felixkoe/MotoSense/Bilder/Bilder Demo Video/Drehzahl test.jpeg

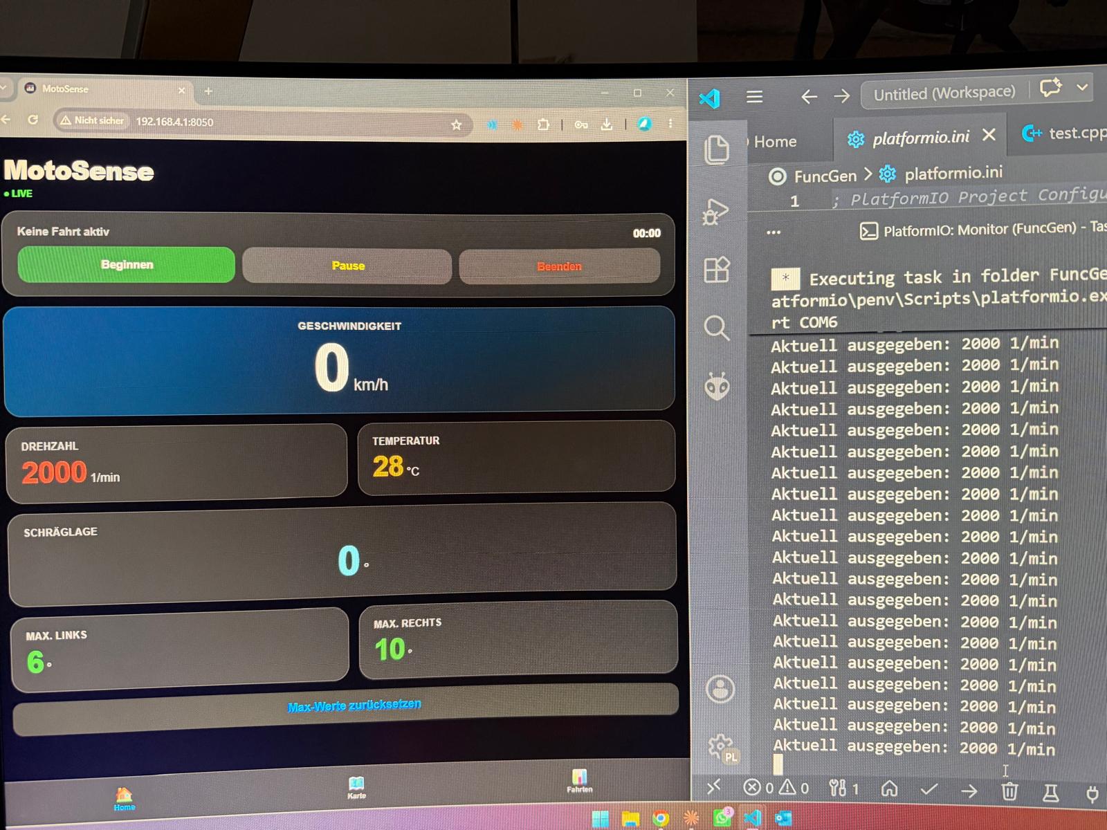
Bilder/Bilder Demo Video/Drehzahl test.jpeg
