felixkoe/MotoSense/Bilder/Bilder Demo Video/Systemaufbau.jpeg

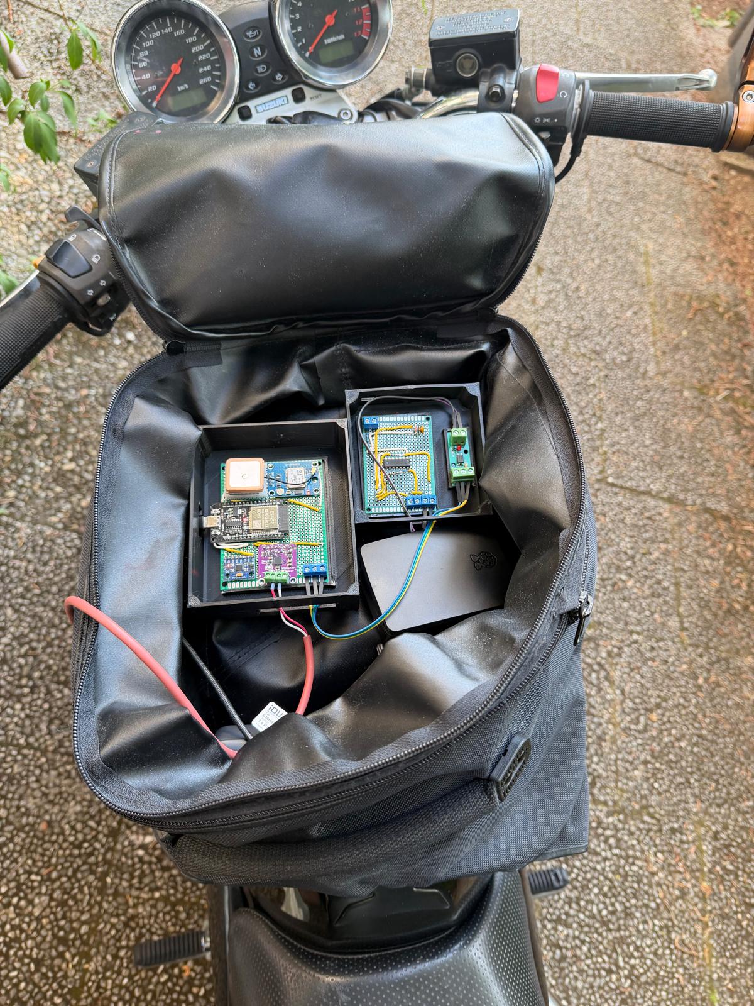
Bilder/Bilder Demo Video/Systemaufbau.jpeg
