felixkoe/MotoSense/Docs/OTH_DAPI_Commit_Historie.pdf

Commit-Historie

Datum | Commit-Nachricht
16.04.2026 | Initial commit
16.04.2026 | created basic folder structure, changed README
16.04.2026 | changed README
16.04.2026 | Erste CAD-Modelle esp32 Sensor gehäuse
18.04.2026 | Schaltplan Drehzahlmesserschaltung (Schmitt-Trigger, Optokoppler)
19.04.2026 | RPM-Gehäuse
26.04.2026 | Stromverteiler-Gehäuse modelliert
02.05.2026 | GPS-Modul (NEO-6M) an UART2 anschließen und testen
05.05.2026 | MPU-6050 an I2C anschließen
10.05.2026 | RPM-Interrupt an GPIO27, Plausibilitätsfilter implementieren
13.05.2026 | lastPulseUs in setup() initialisieren, ISR-Bug beheben
17.05.2026 | Alle Sensoren zusammenführen, JSON-Payload auf motosense/data
22.05.2026 | RPM Debugging
27.05.2026 | fake_esp.py auf 9-Phasen-Fahrsimulation umstellen
01.06.2026 | Mosquitto-Konfiguration, WiFi und MQTT-Publishing am ESP32
03.06.2026 | Erstes Dash-Dashboard mit Gauges, Karte, Temperaturverlauf
06.06.2026 | db.py mit SQLite, RideRecorder und Haversine-Distanz
11.06.2026 | Dash-Callbacks nach Tab aufteilen, MQTT-Subscribe in on_connect, Dashboard finished
14.06.2026 | Raspberry Pi als Access-Point konfigurieren, systemd-Service einrichten
19.06.2026 | Kalibrierungsoffset, Stillstandsschwellwerte und RPM-Parameter anpassen
22.06.2026 | Dokumentation und Video
