felixkoe/MotoSense/Bilder/sensor_board.jpeg

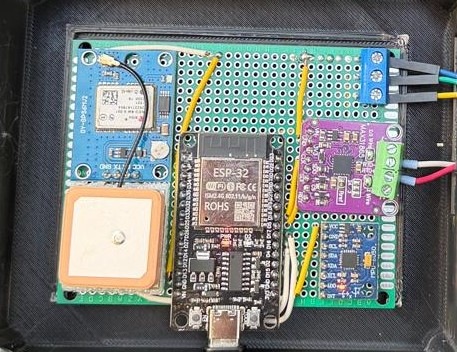
Bilder/sensor_board.jpeg
