felixkoe/MotoSense/Bilder/WhatsApp Image 2026-06-18 at 11.00.58 (1).jpeg

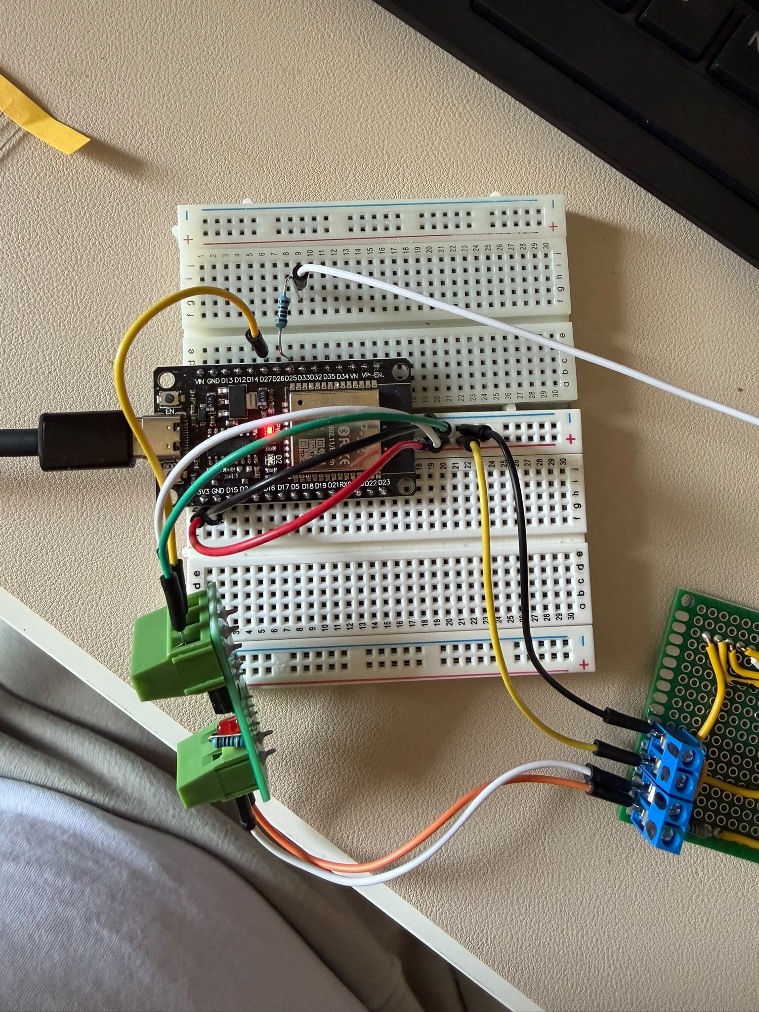
Bilder/WhatsApp Image 2026-06-18 at 11.00.58 (1).jpeg
