felixkoe/MotoSense/Bilder/WhatsApp Image 2026-06-22 at 18.42.49 (1).jpeg

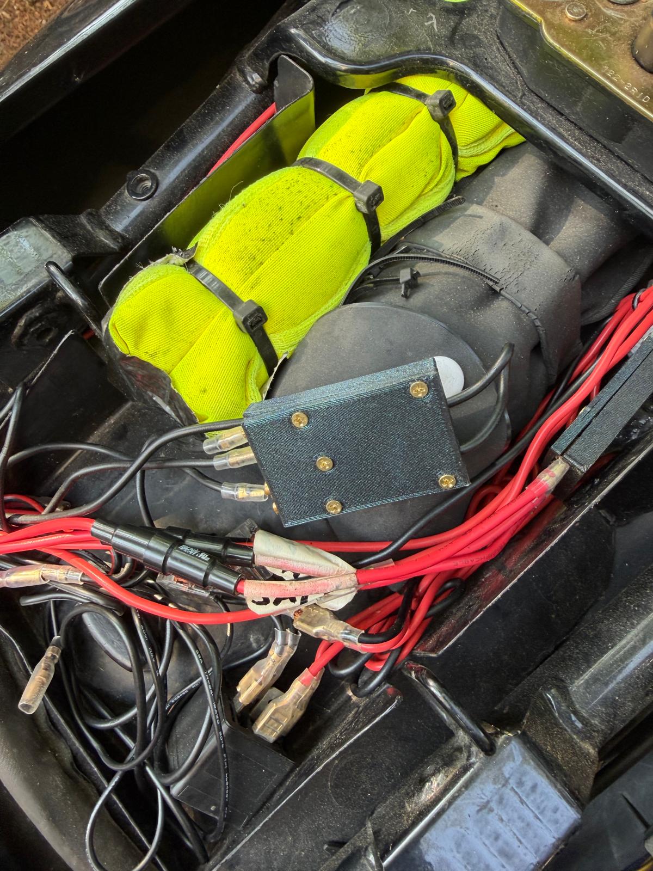
Bilder/WhatsApp Image 2026-06-22 at 18.42.49 (1).jpeg
