felixkoe/MotoSense/Bilder/WhatsApp Image 2026-06-22 at 18.42.49 (5).jpeg

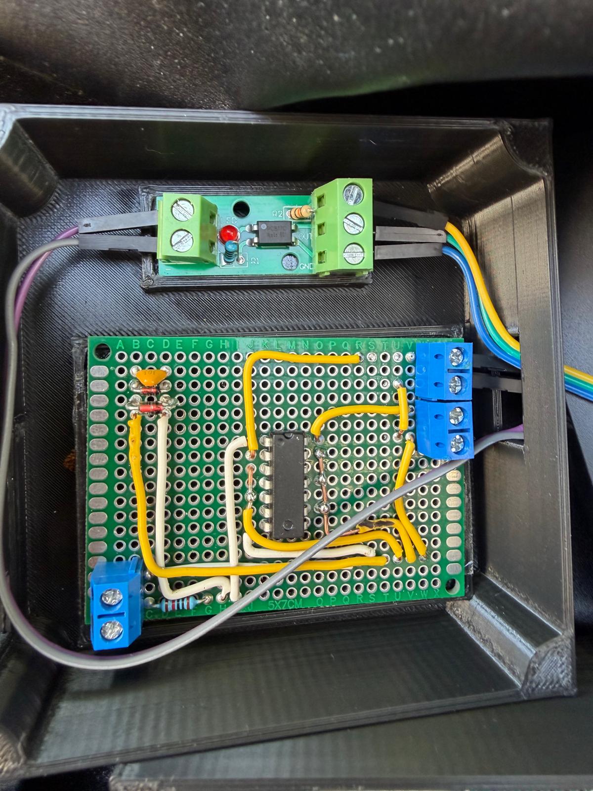
Bilder/WhatsApp Image 2026-06-22 at 18.42.49 (5).jpeg
