felixkoe/MotoSense/Docs/Schaltpläne/Schaltplan RPM Sensor.png

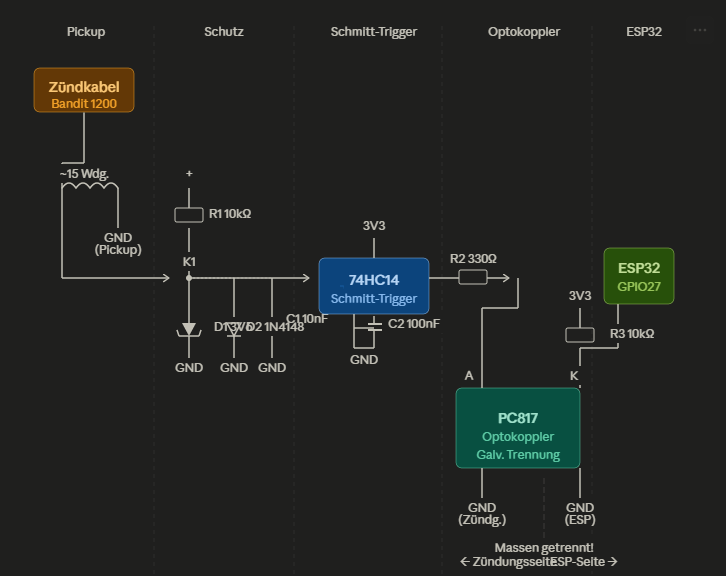
Docs/Schaltpläne/Schaltplan RPM Sensor.png
