felixkoe/MotoSense/CAD/Kabelverteiler_1.stl

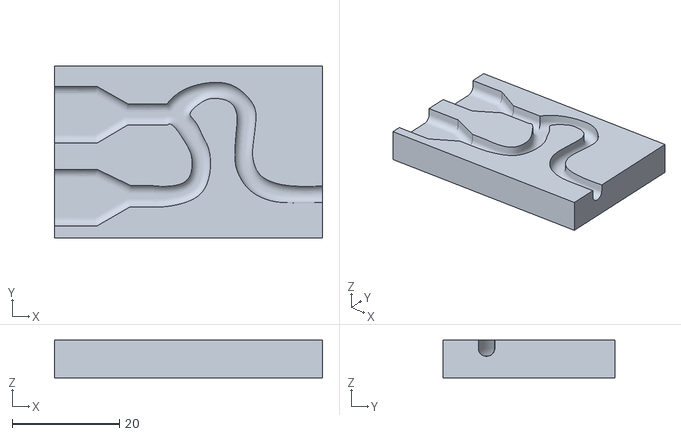
[picture p22: CAD file, 2026-04-25]
CAD/Kabelverteiler_1.stl
50.0 x 32.0 x 7.00
