felixkoe/MotoSense/CAD/Kabelverteiler_2.stl

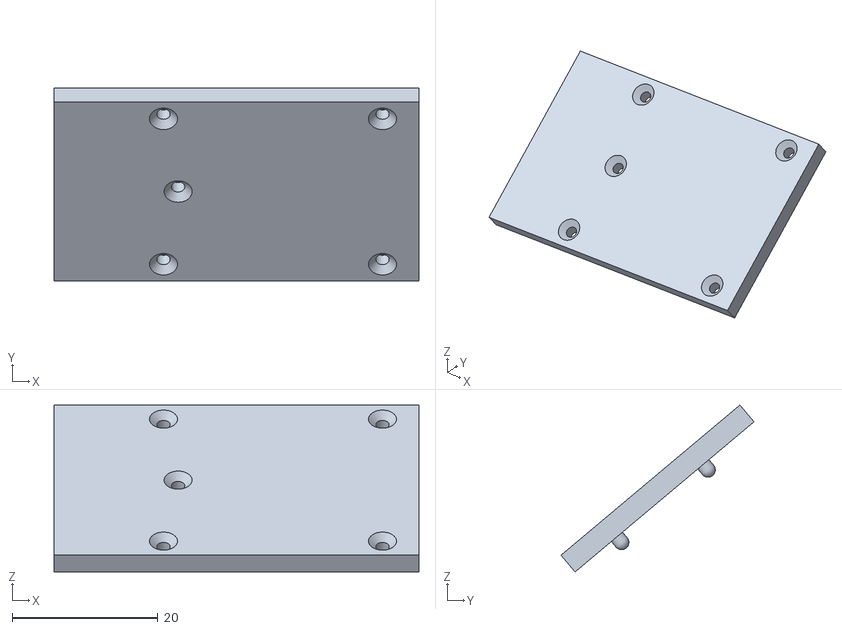
[picture p23: CAD file, 2026-04-25]
CAD/Kabelverteiler_2.stl
50.0 x 26.4 x 22.9
