felixkoe/MotoSense/CAD/RPM_CASE_2.stl

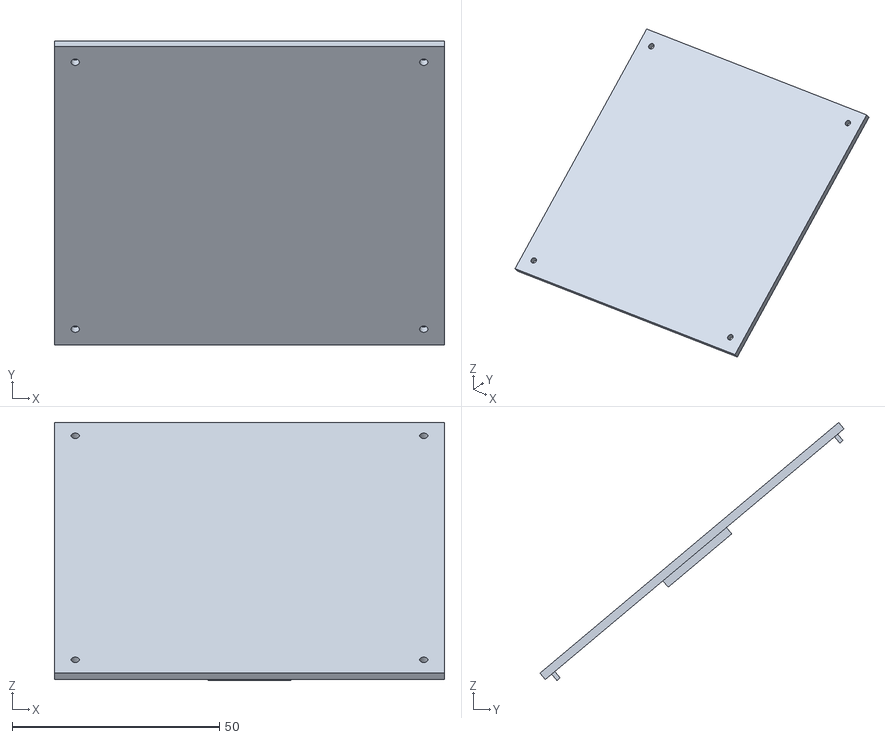
[picture p24: CAD file, 2026-04-19]
CAD/RPM_CASE_2.stl
94.0 x 73.3 x 62.2
