felixkoe/MotoSense/CAD/RPM_CASE_1.stl

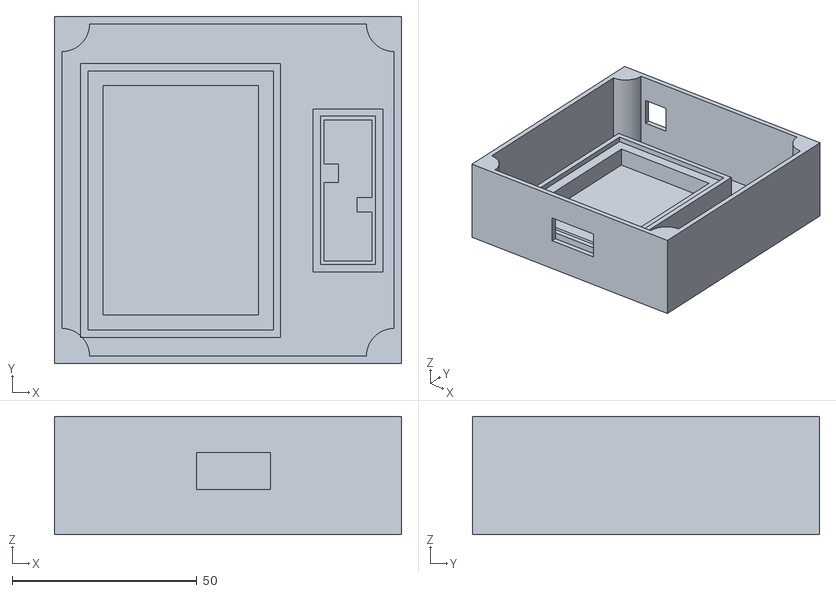
[picture p25: CAD file, 2026-04-19]
CAD/RPM_CASE_1.stl
94.0 x 94.0 x 32.0
