felixkoe/MotoSense/CAD/Sensor_CASE_1.stl

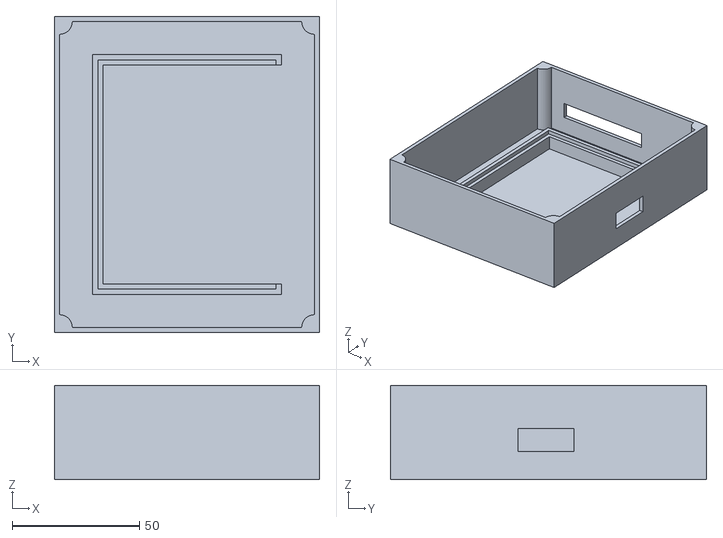
[picture p26: CAD file, 2026-04-16]
CAD/Sensor_CASE_1.stl
104.0 x 124.0 x 37.0
