felixkoe/MotoSense/CAD/Sensor_CASE_2.stl

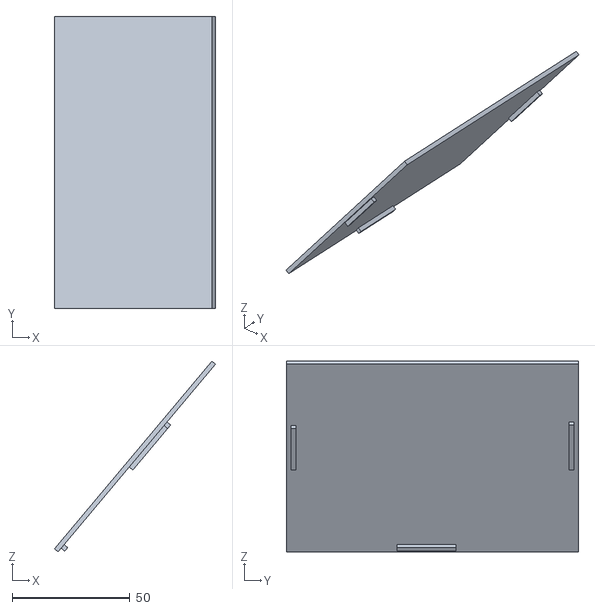
[picture p27: CAD file, 2026-04-16]
CAD/Sensor_CASE_2.stl
68.4 x 124.0 x 81.0
