felixkoe/MotoSense/(commit log)

2026-04-12 added gps and accelerometer to esp
2026-04-16 Erste CAD-Modelle esp32 Sensor gehäuse
    [Sensor_CASE_1.stl, Sensor_CASE_2.stl]
2026-04-19 RPM-Gehäuse
    [RPM_CASE_1.stl, RPM_CASE_2.stl]
2026-04-25 Stromverteiler-Gehäuse modelliert
    [Kabelverteiler_1.stl, Kabelverteiler_2.stl]
2026-05-02 GPS-Modul (NEO-6M) an UART2 anschließen und testen
2026-05-05 MPU-6050 an I2C anschließen
2026-05-10 RPM-Interrupt an GPIO27, Plausibilitätsfilter implementieren
2026-06-01 Mosquitto-Konfiguration, WiFi und MQTT-Publishing am ESP32, ESP Firmware Fertig
2026-06-03 Erstes Dash-Dashboard mit Gauges, Karte, Temperaturverlauf
2026-06-06 db.py mit SQLite, RideRecorder und Haversine-Distanz
2026-06-14 Raspberry Pi als Access-Point konfigurieren, systemd-Service einrichten
2026-06-22 Dokumentation und Video
2026-06-22 Stundenliste und commithistrie als extra Dokument hinzugefuegt
